karolsonchik93/AquariumAi-esp32-s3/build/preview/ui_preview.html

## НЕТ СВЯЗИ С ПЛАТОЙ

Плата перезагружается или пропала сеть. Переподключаюсь автоматически…

—

Аквариум

подключение… --:--:--

## Аквариум

НОРМА —

--°C

—

—

—

🌡

Воздух—

🔥

Нагрев—

—

💡

Свет—

—

КОРМЛЕНИЕ

—

вода, последний час—

## Помпа

—

Реле 1 · фильтрация и перемешивание воды

GPIO4

Остановка на кормление, мин Применить

КОРМЛЕНИЕ

—

## Компрессор

—

Реле 2 · аэрация аквариума

GPIO5

## Вентилятор

—

Реле 3 · охлаждение при перегреве

Авто Вкл Выкл

Включать выше, °C Гистерезис Применить

## Подогреватель

—

Реле 4 · термостат держит температуру сам

Авто 15 мин Выкл

—

## Термостат

—

Уставка, °C Гистерезис, °C Аварийный порог Мощность, Вт Применить

−0.1 +0.1 −0.5 +0.5

## Светильник

Авто Ночник Ручной

—

—

Настроить расписание —

—

Расписание света по дням▾

Сохранить расписание Вернуть как было Скопировать Пн во все дни Будни одним днём —

У каждого дня свои интервалы: рассвет — когда свет включается, закат — когда начинается плавное выключение, ночник до — время, когда ночник гаснет полностью (если поставить время заката, ночник не включится). Переход — сколько минут занимает рассвет и закат. Снимите галочку — в этот день свет не включится вовсе. Изменения вступают в силу после кнопки «Сохранить расписание».

## История температур

1 ч 6 ч 24 ч

вода воздух нагрев свет

## Журнал циклов нагрева

—

Wi-Fi —▾

—

Сеть (SSID) Пароль Подключить Найти сети Забыть сеть

В списке только сети 2,4 ГГц — те, которые плата видит сама. Сеть и пароль сохраняются в энергонезависимой памяти: перепрошивать плату при смене роутера больше не нужно. После успешного подключения точка доступа «Aquarium» погаснет через 30 секунд — плата продолжит работу в вашей сети, новый адрес появится в этом же блоке.

Диагностика и обновление —▾

Обновление прошивки с GitHub нажмите «Проверить обновление» — плата сама скачает свежий файл

Проверить обновление Обновить с GitHub

Виджет для Android квадрат 2×3 на главном экране: температура, уставка, нагрев и свет

Скачать виджет (APK) Привязать к этой плате —

1. Скачайте APK и установите — Android спросит разрешение на установку из браузера.
2. Вернитесь на эту страницу и нажмите «Привязать к этой плате» — приложение получит адрес платы автоматически.
3. В приложении нажмите «Добавить виджет» и подтвердите — виджет 2×3 появится на главном экране.
4. Нажатие на виджет открывает эту страницу, кнопка ⟳ на виджете обновляет данные.

Синхронизировать время Найти датчики Адреса датчиков Взять время с этого устройства Сохранить настройки Сброс Перезагрузка

—

ESP32-S3 · живая телеметрия по SSE · страница хранится в памяти платы, интернет не нужен
