karolsonchik93/AquariumAi-esp32-s3/build/preview/ui_preview_alarm.html

## НЕТ СВЯЗИ С ПЛАТОЙ

Плата перезагружается или пропала сеть. Переподключаюсь автоматически…

—

Аквариум

подключение… --:--:--

## Аквариум

—

--°C

—

вода · DS18B20

## Помпа

—

Реле 1 · фильтрация и перемешивание воды

GPIO4

## Компрессор

—

Реле 2 · аэрация аквариума

GPIO5

## Вентилятор

—

Реле 3 · охлаждение при перегреве

GPIO6

Включать выше, °C Гистерезис Применить Авто

## Подогреватель

—

Реле 4 · термостат держит температуру сам

GPIO7

Нагрев 15 мин Авто

## Термостат

—

Уставка, °C Гистерезис, °C Аварийный порог Мощность, Вт Применить

−0.1 +0.1 −0.5 +0.5

## Светильник

Авто Ночник Ручной

—

Рассвет Закат Ночник до Переход, мин Применить расписание

—

—

## История температур

1 ч 6 ч 24 ч

вода воздух нагрев свет

## Журнал циклов нагрева

—

Wi-Fi —▾

—

Сеть (SSID) Пароль Подключить Найти сети Забыть сеть

В списке только сети 2,4 ГГц — те, которые плата видит сама. Сеть и пароль сохраняются в энергонезависимой памяти: перепрошивать плату при смене роутера больше не нужно. После успешного подключения точка доступа «Aquarium» погаснет через 30 секунд — плата продолжит работу в вашей сети, новый адрес появится в этом же блоке.

Диагностика и обновление —▾

Обновление прошивки с GitHub нажмите «Проверить обновление» — плата сама скачает свежий файл

Проверить обновление Обновить с GitHub

Синхронизировать время Найти датчики Адреса датчиков Сохранить настройки Сброс Перезагрузка

Обновление файлом по воздуху
перетащите сюда файл firmware.bin или нажмите, чтобы выбрать

—

ESP32-S3 · живая телеметрия по SSE · страница хранится в памяти платы, интернет не нужен
