karolsonchik93/AquariumAi-esp32-s3/build/preview/ui_alarm.png

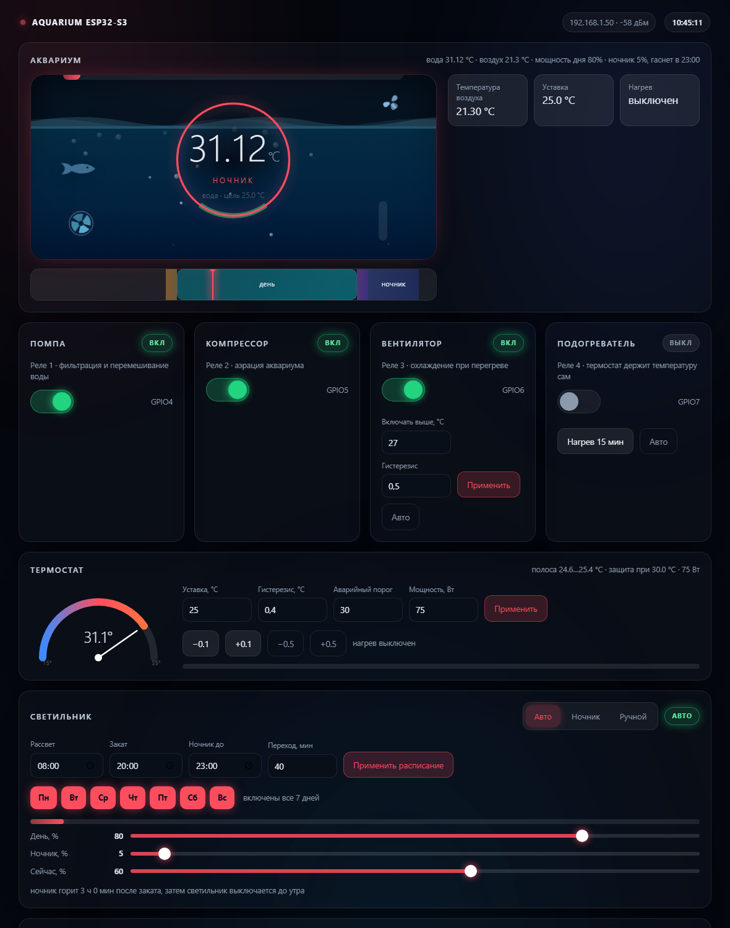
build/preview/ui_alarm.png
