karolsonchik93/AquariumAi-esp32-s3/build/preview/ui_cards.png

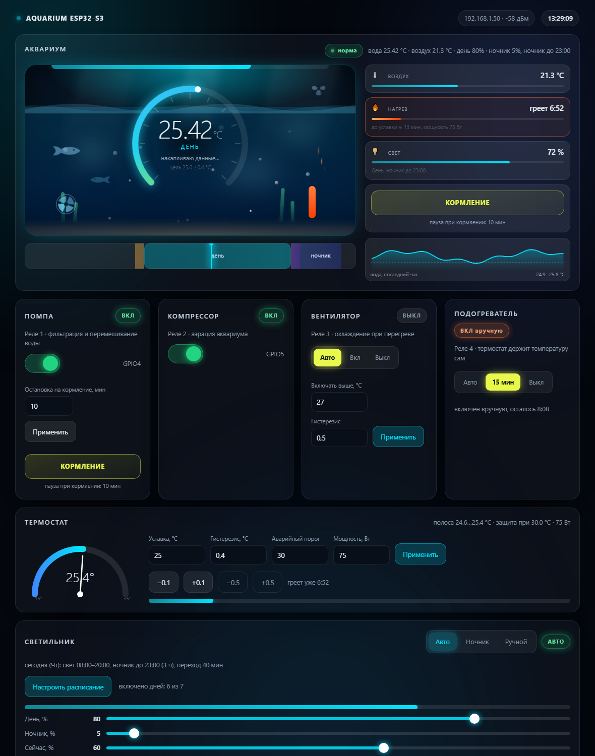
build/preview/ui_cards.png
