karolsonchik93/AquariumAi-esp32-s3/build/preview/ui_hero.png

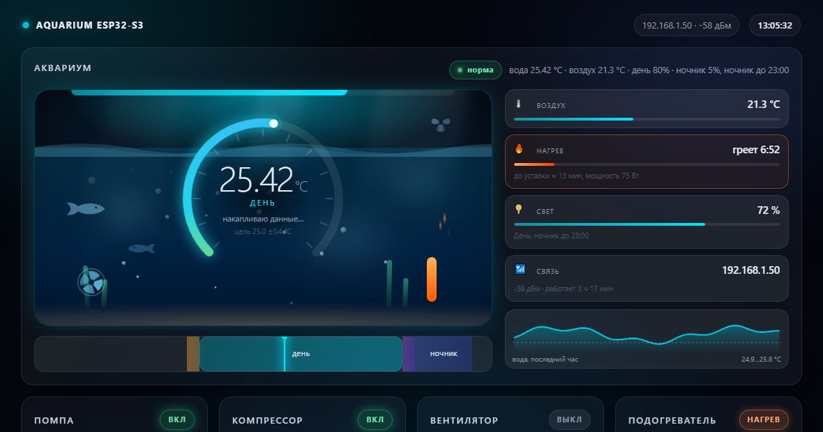
build/preview/ui_hero.png
