karolsonchik93/AquariumAi-esp32-s3/build/preview/ui_sched.png

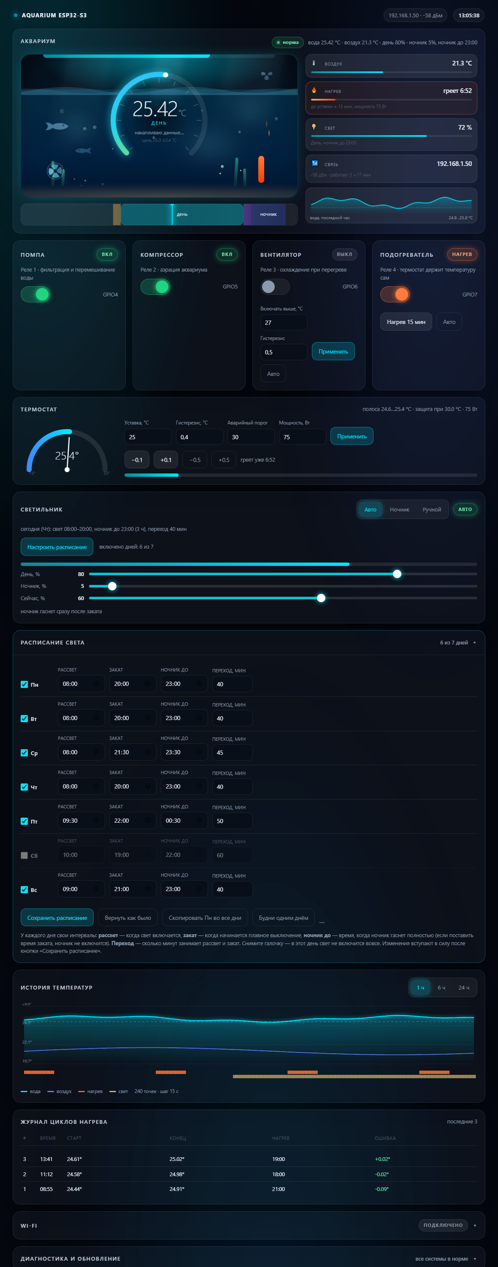
build/preview/ui_sched.png
