karolsonchik93/AquariumAi-esp32-s3/firmware/aquarium_esp32s3/widget_apk.h

/* widget_apk.h - Android widget app embedded into the firmware.
   Generated from aquarium-widget.apk (25399 bytes), version 1.1.0.
   Served by the board at /api/widget.apk. Build: android/build.ps1. */
#pragma once
#define WIDGET_APK_SIZE 25399
static const uint8_t WIDGET_APK[] PROGMEM = {
  0x50,0x4b,0x03,0x04,0x14,0x00,0x00,0x00,0x08,0x00,0x00,0x18,0x21,0x00,0xa6,0x56,0x61,0xa6,0x94,0x05,
  0x00,0x00,0x0c,0x13,0x00,0x00,0x13,0x00,0x00,0x00,0x41,0x6e,0x64,0x72,0x6f,0x69,0x64,0x4d,0x61,0x6e,
  0x69,0x66,0x65,0x73,0x74,0x2e,0x78,0x6d,0x6c,0xa5,0x57,0x4b,0x4f,0x1b,0x57,0x14,0x3e,0x63,0x8f,0xc1,
  0xe1,0x15,0xf3,0x68,0x29,0x60,0xc0,0x21,0x50,0x9e,0x1e,0x1e,0x71,0x08,0x8d,0xaa,0x2a,0x60,0xdc,0x82,
  0x6a,0x08,0xe2,0x29,0x55,0x55,0x5b,0x07,0x93,0x60,0xc5,0x3c,0x6a,0x4c,0x93,0x54,0x55,0x12,0x75,0xd9,
  0x55,0x57,0x59,0x75,0xd9,0x45,0xd5,0x55,0xd4,0x45,0x16,0xf9,0x09,0x5d,0x75,0xd1,0x45,0x7f,0x40,0xd5,
  0x55,0x15,0xf5,0x07,0x54,0x69,0xbf,0x73,0xe6,0x0e,0xbe,0x8c,0x67,0xc2,0x90,0xcc,0xe8,0xc3,0xf7,0x9e,
  0x7b,0xcf,0x77,0x1e,0xf7,0xde,0x73,0x87,0x30,0x45,0xa9,0xa1,0x95,0xc8,0xa0,0x38,0xfd,0x78,0x81,0xe8,
  0x3d,0xd2,0x1e,0xa3,0xd2,0x6c,0x02,0xe2,0xc0,0x10,0x90,0x02,0x16,0x80,0x4f,0x81,0x22,0x70,0x1f,0x78,
  0x02,0x3c,0x05,0x7e,0x05,0x5e,0x00,0x51,0xe8,0xa6,0x80,0x4f,0x80,0xef,0x81,0xe7,0xc0,0x1f,0xc0,0x5f,
  0xc0,0x0b,0xe0,0x25,0xd0,0x12,0x22,0xea,0x07,0xbe,0x06,0x7e,0x01,0x5e,0x02,0xd3,0x61,0xa2,0x87,0xc0,
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
  0xad,0xaa,0x28,0xec,0x4a,0x34,0x2e,0x7e,0xdc,0xc5,0xaf,0x5d,0xab,0xc7,0xab,0x4e,0x7a,0xe3,0xa9,0xf5,
  0x4b,0x4a,0xc5,0x2b,0x4a,0xbf,0x24,0x5e,0xed,0x89,0x46,0x01,0xf2,0x1d,0x55,0xc7,0x2f,0x48,0xdd,0x62,
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
};
