karolsonchik93/AquariumAi-esp32-s3/(commit log)

2026-10-24 feat: аквариумный контроллер на ESP32-S3 (N16R8) с живым веб-интерфейсом
    - прошивка v2.0.0: термостат с защитами, светильник (рассвет/день/закат/ночник), 4 реле
    - два ядра: контур управления на ядре 1, веб-сервер и SSE на ядре 0
    - живая телеметрия по Server-Sent Events, история 24 ч в PSRAM
    - OTA: ArduinoOTA и загрузка .bin со страницы, mDNS aquarium.local
    - аппаратный ШИМ LEDC 12 бит / 5 кГц, watchdog 30 с, настройки в NVS
    - документация, схема подк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
2026-10-24 fix: совместимость с ядром Arduino-ESP32 3.x (v2.0.1)
    - LEDC: ledcAttach(pin)/ledcWrite(pin) для 3.x, ledcSetup/ledcAttachPin для 2.x
    - watchdog: esp_task_wdt_config_t + esp_task_wdt_reconfigure для IDF 5
    - server.available() -> server.accept() в 3.x
    - rgbLedWrite (3.x) / neopixelWrite (2.x) через обёртку rgbWrite
    - README: точные настройки платы (PSRAM OPI, FlashSize 16M, схема разделов с OTA)
    - проверено сборкой ядром 3.3.12: 1 067 018 байт (54%), без ошибок и предупреждений
    [aquarium_esp32s3.ino, config.h, main.ino]
2026-10-24 feat: Wi-Fi со страницы и обновление прошивки с GitHub по кнопке (v2.2.0)
    - настройка сети прямо в браузере: поиск сетей 2,4 ГГц, выбор из списка, пароль
    хранится в NVS; точка доступа гаснет через 30 с после успешного подключения,
    а если сеть не ответила за 45 с — поднимается снова
    - кнопка «Обновить с GitHub»: плата скачивает .bin по OTA_GITHUB_URL, шлёт прогресс
    в браузер и прошивается сама; проверка файла от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
2026-10-24 chore: v2.2.1 — имя сети в логе после подключения
    - в баннере подключения печатается сохранённое имя сети, если WiFi.SSID() ещё пуст
    - прошивка 1 198 506 байт (60%), собрана ядром 3.3.12
2026-10-24 feat: расписание света по дням недели + версия обновления (v2.3.0)
    - у каждого дня свои рассвет/закат/ночник-до/переход и своя галочка активности
    - расписание сохраняется кнопкой, живёт в NVS; свет работает по расписанию текущего дня
    - в интерфейсе отдельная сворачиваемая панель «Расписание света» с 7 строками,
    кнопки «Скопировать Пн во все дни» и «Будни одним днём»
    - проверка обновления п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
2026-10-24 feat: v2.3.1 — расписание с понедельника, верное время, без MKR
    - расписание света показывается с понедельника (данные платы — tm_wday, порядок задаёт страница)
    - время: определение источника через SNTP (время сборки / из памяти / NTP / с устройства),
    кнопка «Взять время с этого устройства» (tset) — верный день недели даже без интернета
    - убрана загрузка прошивки перетаскиванием файла из интерфейса
    -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
2026-10-24 fix: верный день недели в интерфейсе (v2.3.2)
    В JSON состояния было два ключа 'wd': день недели в строке времени и флаг
    сторожевого таймера. JSON.parse оставлял последний, поэтому страница всегда
    показывала 'Пн', а расписание считало сегодняшним понедельник. Флаг сторожа
    переименован в 'wdt', страница читает его оттуда.
    Сам светильник работал правильно: в прошивке решение принимается по настоящем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
    [aquarium_esp32s3.ino, config.h, main.ino]
2026-10-24 feat: новый экран аквариума и Android-виджет 2x3 (v2.4.0)
    Экран аквариума:
    - дуга-индикатор 270° с градиентом, делениями и светящейся точкой в текущем значении
    - лучи света, каустика, колышущиеся растения, песок, две рыбки с разными траекториями
    - правая колонка: воздух, нагрев (сколько греет, сколько осталось), свет, связь — с полосками
    - мини-график температуры воды за час с линией уставки
    - бейдж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
2026-10-24 chore: превью героя ui_hero.png, убраны временные файлы
2026-10-24 fix: UTF-8 строки в Android-виджете и удобные кнопки (v2.4.1)
    - javac собирался без -encoding UTF-8, поэтому русские строки в приложении
    выводились кракозябрами; теперь сборка идёт с -encoding UTF-8, проверка
    подтверждает корректные UTF-8 последовательности прямо в classes.dex
    - кнопки на экране приложения теперь во всю ширину и в прокручиваемом списке
    (раньше текст обрезался на узких экранах)
    - в репозиторий доба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
    [aquarium_esp32s3.ino, config.h, widget_apk.h]
2026-10-24 chore: правильная структура android/ и pio/src
2026-10-24 fix: widget could not be inflated (v2.4.2)
    RemoteViews allows only a fixed set of view classes. The layout used a plain
    <View> as a divider, so launchers failed with 'problem loading widget'.
    - divider is now a TextView with 1dp height
    - ProgressBar uses @android:style/Widget.ProgressBar.Horizontal instead of a
    theme attribute
    - 'no forbidden views' guard added to android/build.ps1
    - verified: compiled layout contains only LinearLayout, TextView, ProgressBar
    [aquarium_esp32s3.ino, config.h, widget_apk.h]
2026-10-27 feat: feeding pause, forced modes, live chart, widget feed button (v2.5.0)
    Firmware:
    - feeding: pump is paused for 1..120 minutes, then returns to the previous state;
    duration and modes are stored in NVS separately from the main settings blob
    - fan/heater: three modes (auto / force on / force off); forced-off beats automation,
    forced-on for the heater still respects sensor and overheat protections
    - schedule: parsing moved into the web task, the board now answers sched=1|0 and the
    page waits for a new sv before touching the fields (fixes values reverting)
    - JSON: fanmode, heatmode, feed, fmin
    Web:
    - KORMLENIE button in the pump card and in the hero (replaced the 'link' row)
    - mode but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
    [aquarium_esp32s3.ino, config.h, main.ino, widget_apk.h]
2026-10-27 fix: JSON buffer overflow and render freeze (v2.5.1)
    - buildStateJson: snprintf returns the length it WOULD write, so w += snprintf(out+w, n-w, ...)
    could underflow n-w and write past the buffer once the JSON grew. Now every append goes
    through addf(), which clamps and sets a truncation flag; buffer raised to 4200 bytes.
    - web: applyState() + renderSafe() wrapper - a single bad field no longer freezes the whole
    page, and the error is shown in a toast instead of silently leaving dashes.
    [aquarium_esp32s3.ino, config.h, main.ino]
2026-11-01 docs: correct LED dimming for 24-60V driver output
    The old wiring guide suggested AO3400A/IRLML2502/IRLZ44N and an IRF520 level-shifter
    option, which is wrong for a 55 V DC rail (30 V / 20 V / exactly 55 V parts, and
    IRF520 is not a logic-level FET - that is why the module overheats).
    Section 7 rewritten: dim the driver itself (DIM input), or use a buck LED driver
    with a PWM input (Mean Well LDD-700H/1000H, 6-60 V), or a logic-level 100 V FET
    (IRL540N) with 5 V gate drive, 200-500 Hz PWM, gate resistor and heatsink.
2026-11-01 docs: how to check LED driver isolation before tying its minus to ESP32 GND
2026-11-01 tune: LED PWM 1 kHz for optocoupler/dimmable-driver setups (v2.5.2)
    5 kHz is fine for a fast discrete FET, but the EL817 optocoupler in common
    MOSFET modules needs 5-20 us to turn off, so at 5 kHz a noticeable part of each
    period is spent in the linear region. 1 kHz keeps the light flicker-free and
    lets slow switches fully open and close.
2026-11-01 docs: which ready-made MOSFET modules suit a 24-60V LED driver output
2026-11-01 docs: checklist to spot a PWM-capable MOSFET module (pot, latch, voltage, opto)
